ak4754710/rfr27-newmember-08/hardware/Temp_Board_Schematic.pdf

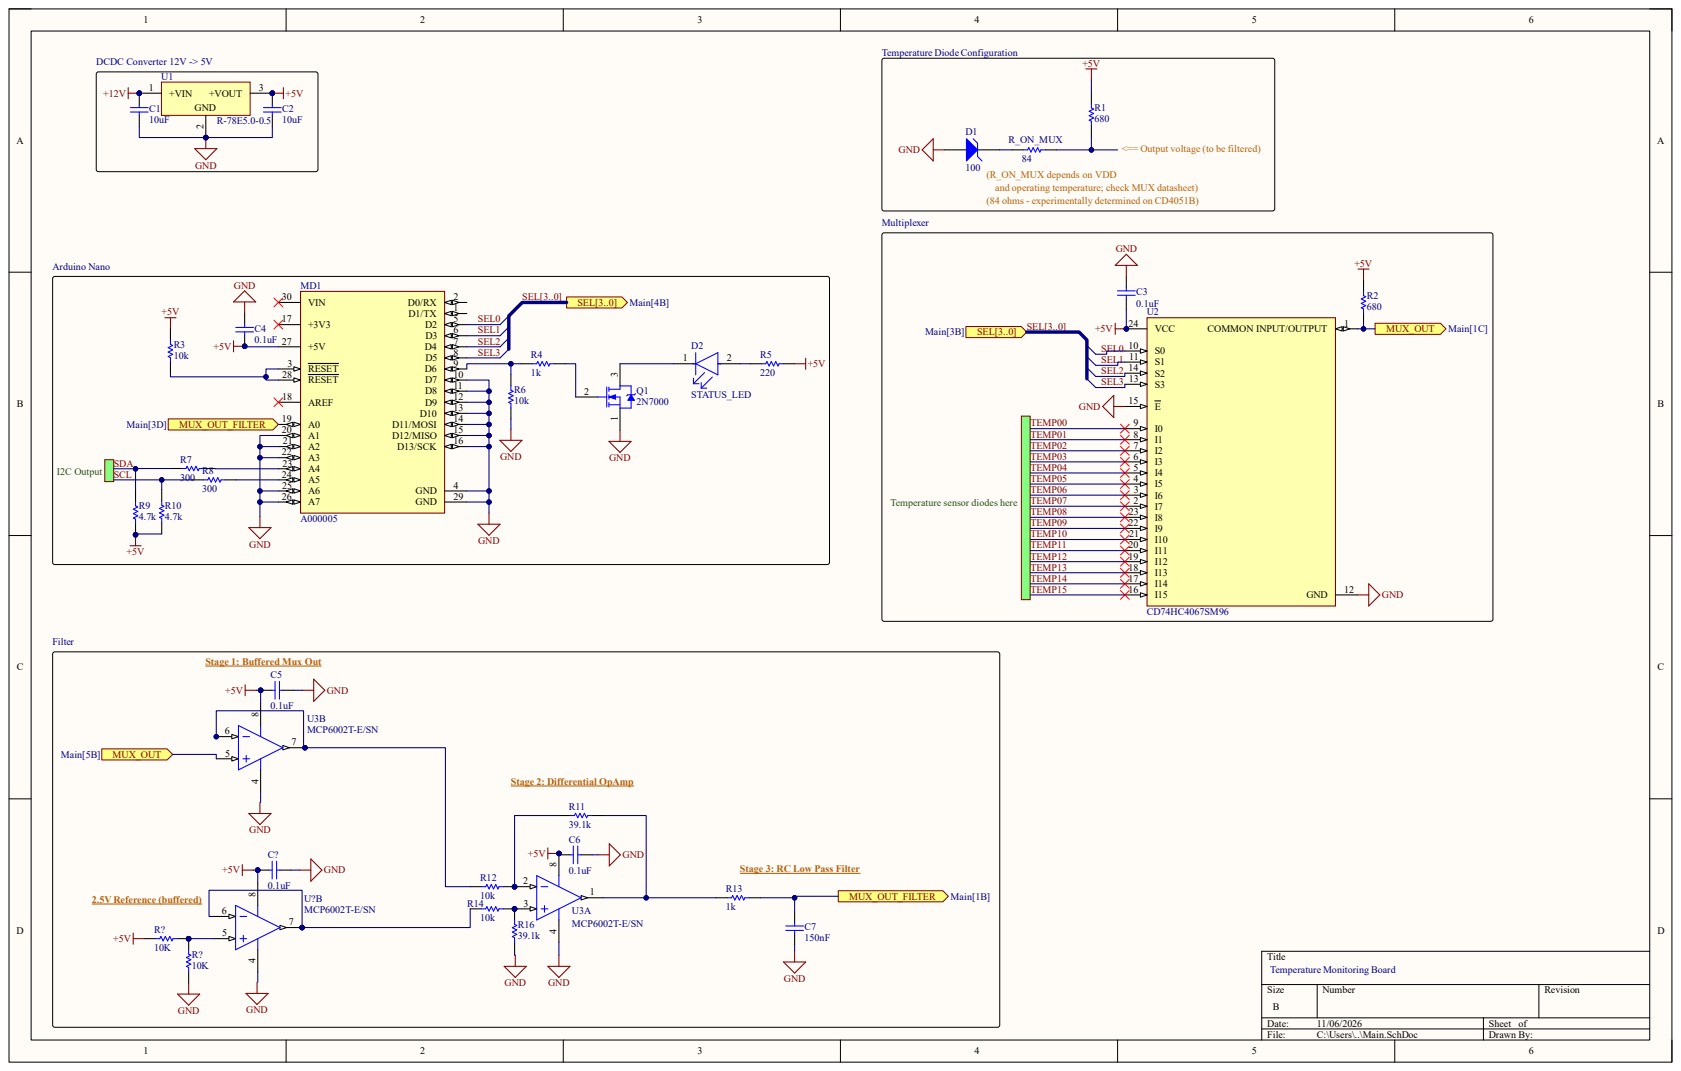
[picture p4: page 1]

(R_ON_MUX depends on VDD
and operating temperature; check MUX datasheet)
(84 ohms - experimentally determined on CD4051B)

Temperature sensor diodes here

Stage 1: Buffered Mux Out
