ak4754710/rfr27-newmember-08/(list of files, drawings)

Other design files:
hardware/Temp_Board/Main.SchDoc
hardware/Temp_Board/Temp_Board.PrjPcb
Temp_Board.PrjPcb
