ak4754710/rfr27-newmember-08/(commit log)

2026-10-09 week 1 software updates: flowchart + function declarations
2026-10-15 feat(schematic): started initial schematic
2026-10-15 feat(schematic): added power ports for Vin and +5V pin and additional TODO comments
2026-10-18 DCDC, MUX, and Arduino Uno
2026-10-18 Project was moved to the native VCS repository (Versioned Storage) in your Altium Server. Your local project (local repository) now needs to be switched to point to this new remote repository. Please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
2026-10-18 feat(schematic): added RC low pass filter and opamp gain, bypass caps, status LED, additional ignore DRC directives, labels on sensor inputs and I2C output
2026-10-18 feat(schematic): added RC low pass filter and opamp gain, bypass caps, status LED, additional ignore DRC directives, labels on sensor inputs and I2C output (auto)
2026-10-18 docs: added pdf of schematic
2026-10-18 fix: ensure schematic up to date with remote
2026-10-18 feat(schematic): added caps to dcdc and supplied power through +5V pin instead of Vin
2026-10-18 docs: updated schematic pdf
2026-10-18 fix(schematic): should be a non-inverting opamp
2026-10-21 feat(schematic): pull up resistor for temp diodes and I2C, configured unused opamp, 10uF caps on DCDC converter as per spec sheet
2026-10-26 feat(schematic): keep schematic up-to-date
2026-10-31 feat(schematic): updated signal conditioning; added differential opamp, buffered multiplexer input (prevent 70ohm voltage drop from MUX), updated low pass filter for ~10k cutoff
2026-10-31 feat(schematic): control LED with MOSFET, appropriately sized I2C pull up resistors (4.7k), added current limiting resisors (300ohm) to I2C lines off arduino
2026-10-31 feat(schematic): added temp sensor diode configuration from datasheet for easier reading, changed annotation style
2026-10-31 feat(schematic): detailed temp diode configurationwith R_ON from the 8 channel MUX (CD4051BE) datasheet @Vss = 5V
2026-11-03 chore: cleaned up repo, sorted files and updated from 16 to 8 sensor build
2026-11-05 feat: implement eight-channel temperature scanner firmware
2026-11-06 fix: update sensor voltage calculations and correct temperature conversion logic
2026-11-06 feat(schematic): added buffered 2.5V reference for input into the differential opamp
2026-11-06 feat(firmware): voltage-temperature conversion now takes into account reference voltage
2026-11-06 feat(schematic): added annotation about where R_ON_MUX=84ohms came from
2026-11-06 feat(schematic): boxed sections of schematic
